msualp/sociail-assistant/docs/prototype/v3/r3-2-loose/README.md

# v3 R3.2 Loose (MagSafe)

Generated print assets for the v3.2 holistic redesign: smooth bottom-led taper, deeper edge recess, and stronger corner softness.

## What Changed vs R3
- Maintains R3 exterior polish, ergonomics, and MagSafe alignment bossing
- Looser seam tuning for faster A/B iteration and easier repeated opening
- Lower insertion force with reduced snap engagement

## Files
- `shell-top.stl`, `shell-bottom.stl`
- `shell-top-print.stl`, `shell-bottom-print.stl`
- `shell-top-print-screws.stl`, `shell-bottom-print-screws.stl`
- `neg-magsafe-ring.stl`, `neg-led-window.stl`, `neg-button.stl`
- `neg-usbc-bottom.stl`, `neg-mic-array.stl`, `neg-speaker-grill.stl`
- `neg-screw-holes-4x.stl`

## Print Orientation
- Top: seam-down (open cavity up, split plane on bed)
- Bottom: upright (flat back on bed)

## Bambu Slicer Baseline
- Layer height: `0.16` or `0.20`
- Walls: `4`
- Top/Bottom layers: `6`
- Supports: `off` (enable only if your machine/profile bridges poorly near side I/O)
