msualp/sociail-assistant/docs/prototype/v3/r3-2/README.md

# v3 R3.2 Deep Sculpt (MagSafe)

Generated print assets for the v3.2 holistic redesign: deeper perimeter recess, fuller corner softening, and stronger top-to-bottom sculpting.

## What Changed vs R2
- Larger perimeter edge rounds and softened crown transitions
- Added subtle side/shoulder contouring for improved in-hand comfort
- Added MagSafe pocket alignment bossing + anti-rotation key
- Upgraded seam to 6 snap points for stronger, more even retention
- Tuned clearances for repeatable assembly/disassembly on FDM prints
- Geometry tuned to print cleanly in recommended orientations with minimal supports

## Files
- `shell-top.stl`, `shell-bottom.stl`
- `shell-top-print.stl`, `shell-bottom-print.stl`
- `shell-top-print-screws.stl`, `shell-bottom-print-screws.stl`
- `neg-magsafe-ring.stl`, `neg-led-window.stl`, `neg-button.stl`
- `neg-usbc-bottom.stl`, `neg-mic-array.stl`, `neg-speaker-grill.stl`
- `neg-screw-holes-4x.stl`

## Print Orientation
- Top: seam-down (open cavity up, split plane on bed)
- Bottom: upright (flat back on bed)

## Bambu Slicer Baseline
- Layer height: `0.16` or `0.20`
- Walls: `4`
- Top/Bottom layers: `6`
- Supports: `off` (enable only if your machine/profile bridges poorly near side I/O)
