msualp/sociail-assistant/docs/prototype/v3/r3-1-r3-mid/README.md

# v3 R3.1-r3 Mid (MagSafe)

Generated print assets for the v3.1-r3 holistic redesign: smooth bottom-led taper, deeper edge recess, and stronger corner softness.

## What Changed vs R3
- Maintains R3 exterior polish, ergonomics, and MagSafe alignment bossing
- Mid seam tuning between r3-loose and r3-tight for balanced retention
- Moderate insertion force for daily open/close testing

## Files
- `shell-top.stl`, `shell-bottom.stl`
- `shell-top-print.stl`, `shell-bottom-print.stl`
- `shell-top-print-screws.stl`, `shell-bottom-print-screws.stl`
- `neg-magsafe-ring.stl`, `neg-led-window.stl`, `neg-button.stl`
- `neg-usbc-bottom.stl`, `neg-mic-array.stl`, `neg-speaker-grill.stl`
- `neg-screw-holes-4x.stl`

## Print Orientation
- Top: seam-down (open cavity up, split plane on bed)
- Bottom: upright (flat back on bed)

## Bambu Slicer Baseline
- Layer height: `0.16` or `0.20`
- Walls: `4`
- Top/Bottom layers: `6`
- Supports: `off` (enable only if your machine/profile bridges poorly near side I/O)
