msualp/sociail-assistant/docs/prototype/v3/r3-1-r2-tight/README.md

# v3 R3.1-r2 Tight (MagSafe)

Generated print assets for the v3.1-r2 holistic redesign: stronger all-around corner rounding and full-body trapezoidal draft shaping.

## What Changed vs R3
- Maintains R3 exterior polish, ergonomics, and MagSafe alignment bossing
- Tighter seam tuning for stronger retention under repeated handling
- Higher insertion force with increased snap engagement

## Files
- `shell-top.stl`, `shell-bottom.stl`
- `shell-top-print.stl`, `shell-bottom-print.stl`
- `shell-top-print-screws.stl`, `shell-bottom-print-screws.stl`
- `neg-magsafe-ring.stl`, `neg-led-window.stl`, `neg-button.stl`
- `neg-usbc-bottom.stl`, `neg-mic-array.stl`, `neg-speaker-grill.stl`
- `neg-screw-holes-4x.stl`

## Print Orientation
- Top: seam-down (open cavity up, split plane on bed)
- Bottom: upright (flat back on bed)

## Bambu Slicer Baseline
- Layer height: `0.16` or `0.20`
- Walls: `4`
- Top/Bottom layers: `6`
- Supports: `off` (enable only if your machine/profile bridges poorly near side I/O)
