msualp/sociail-assistant/docs/prototype/v3/templates/README.md

# v3 PCB Keepout Templates

Centered PCB templates for v3 r3 internals.

## Files
- `pcb-keepout-60x46.stl`
- `pcb-keepout-60x46.dxf`
- `pcb-keepout-62x48.stl`
- `pcb-keepout-62x48.dxf`

## Geometry Basis
- Cavity envelope: `71.6 x 58.4 x 11.2 mm`
- Bottom cavity: `6.81 mm`
- Top cavity: `4.41 mm`

## Notes
- STLs are board placeholders at `1.6 mm` thickness, centered at origin.
- DXFs include board outline, cavity reference outline, centerlines, and dimensions.
- For a stated `35 x 86 mm` board: not a fit in this enclosure (straight or diagonal) against the 71.6 x 58.4 mm cavity envelope.
