msualp/sociail-assistant/docs/prototype/v3/polished-r1/README.md

# v3 Polished R1 (MagSafe)

Generated print assets for a modern, rounded MagSafe-friendly enclosure.

## What Changed vs Draft
- Flat back maintained for MagSafe + table stability
- Softer perimeter + top crown for better in-hand feel
- Added tongue-and-groove seam and 4 snap tabs for sturdier assembly
- Normalized print-ready shells with optional screw-hole variants

## Files
- `shell-top.stl`, `shell-bottom.stl`
- `shell-top-print.stl`, `shell-bottom-print.stl`
- `shell-top-print-screws.stl`, `shell-bottom-print-screws.stl`
- `neg-magsafe-ring.stl`, `neg-led-window.stl`, `neg-button.stl`
- `neg-usbc-bottom.stl`, `neg-mic-array.stl`, `neg-speaker-grill.stl`
- `neg-screw-holes-4x.stl`

## Print Orientation
- Top: upside-down (hero face on bed)
- Bottom: upright (flat back on bed)
