msualp/sociail-assistant/docs/7-Sociail-Assistant/2-Sociail-Assistant-Strategy.md

# 📓 Sociail Wiki  
## Strategy Brief: **Sociail Assistant** Peripheral

> **Purpose**  
> Document why a pocket-sized mic / speaker / LED device—**Sociail Assistant**—can be a game-changer for our Shared-Intelligence platform, outlining benefits, risks, and a disciplined path to execution.

---

### 1 | Strategic Fit

| Dimension | How Sociail Assistant Advances the Mission |
|---|---|
| **Unified Collaboration Canvas** | Extends Sociail from _lean-forward_ chat (keyboard / screen) to _lean-back_ voice (hands-free, eyes-free). Users can move fluidly between desktop, phone, and physical spaces without context loss. |
| **Data Depth & Quality** | Captures micro-interactions (voice notes, ambient questions) that users never bother to type, enriching the Shared-Intelligence graph for smarter agent routing and RAG. |
| **Privacy & Context Management** | Space switching enables work/life separation, addressing enterprise compliance needs while respecting personal privacy. "Use Personal Space" keeps shopping lists away from team chat. |
| **Differentiation & Moat** | Competitors live inside apps. A branded, always-ready peripheral stakes physical territory. iPhone-first approach with Element-X foundation creates platform lock-in. |
| **Engagement & Retention** | The device's light/sound presence nudges daily use; habituation drives higher monthly active users (MAU) and subscription stickiness. Space switching increases usage across life contexts. |
| **New Revenue Lever** | Hardware margin (65% gross) plus bundled "Sociail Pro" upsells diversify ARR. Enterprise tiers unlock B2B field service and accessibility markets. |
| **Sustainability Leadership** | 65% recycled materials, mail-back program, and carbon neutral roadmap appeal to ESG-conscious consumers and enterprises. |

---

### 2 | Pros & Cons

| ✅ **Pros** | ❌ **Cons / Risks** | 🛠 **Mitigations** |
|---|---|---|
| **Instant AI Access** – Wake-word or tap; < 200 ms RTT. | Latency or wake-word failures hurt brand trust. | _Brain-in-Phone_ design keeps compute on iPhone; prototype until RTT < 200 ms in noisy envs. |
| **Ambient Collaboration** – RGB ring makes AI presence visible; great for teams. | Privacy concerns over "constantly listening" device. | Hardware mic-cut switch ➜ red LED; on-device wake-word; publish privacy white-paper. |
| **Cross-Context Continuity** – Car → shop → desk with one identity. | Fragmented UX if firmware, iOS app, and cloud fall out of sync. | One backlog; same PM; treat peripheral as a sprint lane of iOS roadmap. |
| **Hardware Margin & Upsell** – $99–149 MSRP, 65% gross. | Inventory ties up cash; RMAs can crush margin (cf. Humane Pin). | Crowdfund / preorder to gauge demand; CM on-demand builds; hold < 2 months inventory. |
| **TAM Expansion** – Field workers, makers, accessibility users. | Focus dilution at early stage. | Gate each phase (Alpha 20, Beta 1,000, Pilot 10,000) on NPS/usage KPIs; kill if metrics lag. |
| **Space Isolation** – Work/personal separation drives adoption. | Complexity in voice commands. | Simple commands: "Use [Space]"; visual feedback via LED patterns; in-app tutorial. |

---

### 3 | Why It Could Be a Game-Changer

1. **Creates a True "Shared Intelligence" Mesh**  
   - Chat clients cover _where we type_. Sociail Assistant covers _where we move_.  
   - Voice snippets, sensor data, and camera hand-offs fuse into a richer, time-stamped knowledge stream.
   - Space switching enables context-appropriate AI responses without privacy concerns.

2. **Unlocks Under-Served Moments**  
   - Driving, operating machinery, cooking, lab work—currently dead zones for AI collaboration.  
   - Every reclaimed minute boosts velocity of idea capture and team alignment.
   - Personal tasks (gift shopping, health tracking) stay separate from work streams.

3. **Strengthens Brand Story**  
   - Positions Sociail as the platform that **meets users where they are**, not just another chat app.  
   - Hardware acts as a physical "logo" on desk or dashboard—constant mindshare.
   - Sustainability commitment differentiates from disposable tech.

4. **Bootstraps an Ecosystem**  
   - BLE GATT is public; third parties can build mounts, sensor modules, kiosk docks.  
   - Early hardware success paves way for automotive, home-hub, and wearable variants.
   - Developer SDK enables vertical-specific applications.

---

### 4 | Execution Guard-Rails

| Stage | Go / No-Go Metric | Owner | Notes |
|---|---|---|---|
| **P0 Proof** (dev-board) | RTT < 250 ms, wake-word accuracy > 90%, Space switching works | Firmware | Use nRF52840-DK + MEMS mic shield. |
| **Alpha 20-Unit EVT** | NPS ≥ 60 from internal & power users | Product | 4-week soak; test in car/workshop/kitchen. |
| **Beta 1,000-Unit DVT** | Daily Voice Intents ≥ 10, Space adoption > 50%, attach rate > 30% | Data | A/B test $99 vs $149 pricing. |
| **Pilot 10,000-Unit PVT** | Return rate < 5%, margin ≥ 65%, enterprise LOIs ≥ 5 | Ops/Finance | Validate trade-in program, sustainability metrics. |
| **Launch** | 60,000 units Year 1, 40% subscription attach | Marketing | Retail partnerships, developer program launch. |

---

### 5 | Revenue Model Deep-Dive

| Revenue Stream | Target | Year 1 | Year 2 | Year 3 |
|---|---|---|---|---|
| **Hardware Sales** | Consumer @ $149, Wired @ $99 | $8.9M | $37.3M | $74.5M |
| **Sociail Pro** | 40% → 55% → 65% attach @ $9.99/mo | $1.4M | $9.8M | $28.4M |
| **Enterprise** | Teams @ $29.99/mo/device | $0.5M | $5.2M | $15.3M |
| **Accessories** | Mounts, sensors @ $29-49 | $0.2M | $2.1M | $8.2M |
| **Total Revenue** | | $11.0M | $54.4M | $126.4M |

---

### 6 | Risk Checklist & Mitigations

| Risk Category | Threat | Mitigation |
|---|---|---|
| **Technical** | BLE dropouts in RF-noisy shops | Classic BT fallback; antenna rigor in EVT; 5m pickup validation. |
| **Regulatory** | FCC/CE delays | Pre-scan at EVT; hire specialist lab early; UN 38.3 for battery model. |
| **Financial** | Hardware eats > 25% runway | Milestone-tied convertible note or preorder cash; enterprise pilots for revenue. |
| **Focus** | Core app lag from split attention | Shared roadmap; hardware sprints limited to 20% eng capacity until Beta success. |
| **Market** | Big-tech copycats | Patent utility (Space switching + iPhone camera integration); 18-month first-mover window. |
| **Environmental** | E-waste perception | 65% recycled materials, mail-back program, carbon neutral by 2027; B Corp cert. |
| **Privacy** | Enterprise data concerns | SOC 2 compliance, GDPR/CCPA ready, on-device wake word, E2E encryption. |

---

### 7 | Competitive Moat Timeline

| Time | Our Advantage | Competitor Response | Our Counter |
|---|---|---|---|
| **Month 0-6** | First voice peripheral for collaborative AI | Likely dismissive | Ship fast, grab mindshare |
| **Month 6-12** | iPhone integration + Space switching | Amazon/Google notice | Patent filings, exclusive Element-X features |
| **Month 12-18** | Developer ecosystem + enterprise deals | Big tech announces similar | Vertical specialization, B2B lock-in |
| **Month 18+** | Embedded base + multi-device mesh | Commoditization risk | Premium features, sensor modules, AI advances |

---

### 8 | Next-Step Checklist (Updated)

| Timeline | Action | Lead | Dependency |
|---|---|---|---|
| **Week 0-1** | Define Space voice commands & LED patterns | UX | Product vision |
| **Week 1-2** | Finalize BLE GATT & privacy architecture | iOS / FW | Security review |
| **Week 2-4** | Build P0 prototype & latency test | Firmware | Dev boards ordered |
| **Week 4-6** | Fork Element-X iOS: add Device Manager + Spaces | Mobile | Stable GATT |
| **Week 6** | Decision Gate 1: Promote to EVT? | Founders | RTT, accuracy, Space demo |
| **Month 2-3** | EVT 20-unit run + real-world testing | HW / CM | ID drawings, BOM |
| **Quarter 2** | Beta 1,000 units + preorder campaign | Marketing | EVT learnings, pricing validation |
| **Quarter 3** | Pilot 10,000 units + enterprise trials | Sales | Beta success, B2B pipeline |
| **Quarter 4** | Launch manufacturing + retail partnerships | Ops | Pilot metrics, inventory plan |

---

### 9 | Success Metrics Framework

| Metric Category | Alpha (20) | Beta (1,000) | Pilot (10,000) | Launch (60,000) |
|---|---|---|---|---|
| **Usage** | 5 intents/day | 10 intents/day | 15 intents/day | 20 intents/day |
| **Cross-Context** | 2 locations/day | 3 locations/day | 4 locations/day | 5 locations/day |
| **Space Adoption** | 30% use 2+ spaces | 50% use 2+ spaces | 70% use 2+ spaces | 80% use 2+ spaces |
| **Work/Personal Split** | - | 60/40 ratio | 50/50 ratio | Configurable |
| **NPS** | 60+ | 70+ | 75+ | 80+ |
| **Return Rate** | - | < 10% | < 5% | < 3% |
| **Sub Attach** | - | 30% | 40% | 50% |

---

### 10 | Recommendation

Proceed with an **ambitious but milestone-gated program**:

- **Cost to Beta:** <$250K (increased units for better validation)
- **Runway Impact:** 10-15% if managed well, with crowdfunding offset
- **Strategic Upside:** Massive—defines new category, locks in competitive moat, opens B2B markets
- **Sustainability Edge:** First AI hardware with circular economy commitment

> **Verdict:** _Pursue aggressively, but maintain discipline. The Space switching innovation + iPhone-first approach + sustainability story create a unique window. Scale faster than original plan to capture market before big tech responds._

### Key Strategic Insight

**Sociail Assistant isn't just a voice peripheral—it's a privacy-respecting, context-aware AI companion that makes the Sociail platform indispensable across all life moments.** The combination of Space switching, iPhone integration, and sustainable design creates multiple defensible moats.

---

*Maintainer: `@product-team` · Last updated: 2025-06-01*
