msualp/sociail-assistant/docs/7-Sociail-Assistant/5-Sociail-Assistant-Concept.html

Coming Soon

# Sociail Assistant

Bringing Shared Intelligence From Lean-Forward to Lean-Back

### 🎤 3-Mic Array with Beamforming

Far-field voice capture up to 5 meters with advanced noise cancellation. Powered by Knowles IA-611 MEMS technology.

### 🔊 Room-Filling Audio

28mm driver with 3W peak power delivers clear AI responses. Perfect for workshops, vehicles, or open spaces.

### 💡 Ambient RGB Status Ring

12 RGB LEDs show device states: ready (blue), listening (pulse), thinking (purple), speaking (green), muted (red).

### 🔋 All-Day Battery Life

1800mAh Li-Po battery provides 12+ hours of active use. USB-C fast charging and optional wireless charging.

🔌

### Connectivity

BLE 5.3 Audio, Nordic nRF52840 MCU, iPhone-first architecture with "Brain-in-Phone" design

🔋

### Power Options

Wired-only ($99) or Battery model ($149) with 12+ hours active use, Qi wireless charging

🎯

### Smart Features

Wake word on iPhone, <100ms response, multi-user voice profiles, privacy-first with hardware mute

🔮

### Expandable Platform

I²C expansion port for future sensors: temperature, air quality, gesture control, and custom modules

## Perfect For Every Situation

🔧

### Auto Repair

"Hey Sociail, torque spec for this alternator"

🚗

### Commute

Get team updates and respond hands-free

👨‍🍳

### Cooking

"Is this steak medium-rare?" with camera

🪜

### On a Ladder

Add reminders and tasks while working

♿

### Accessibility

Voice-first interface for all users

👥

### Collaboration

Pass device for group brainstorming
