msualp/sociail-assistant/docs/prototype/v2/r3-loose/README.txt

Sociail Assistant v2.0 (W35) - GENERATED R3-LOOSE POLISHED PRINT ASSETS
Generated: 2026-03-05

This folder contains parametric STL meshes generated from
../docs/design-spec.md dimensions for Bambu Studio use.

Implemented in this pass:
- 5.2mm continuous body rounds with subtle side/shoulder contouring
- 1.0mm tongue-and-groove seam (0.18mm clearance target, looser fit)
- 4x snap tabs near end arcs (+/-30deg locations), tuned for lower insertion force and easier hand assembly
- Internal-fit pack: board rails, snap-switch cradle, speaker seat, mic guides, USB collar, LED end stops, battery tray

Canonical parts:
- shell-top.stl
- shell-bottom.stl

Negative cutouts:
- neg-usbc-left-tunnel.stl
- neg-led-window.stl
- neg-button-well.stl
- neg-mic-array.stl
- neg-speaker-grill.stl
- neg-screw-holes-4x.stl (optional)

Direct print-ready variants:
- shell-top-print.stl
- shell-bottom-print.stl
- shell-top-print-screws.stl
- shell-bottom-print-screws.stl

Bambu orientation:
- Top shell: upside-down (hero side on bed)
- Bottom shell: upright (cavity up)
