msualp/sociail-assistant/docs/prototype/modules/button-module-22-24-v1/bezel_guard_22mm.stl

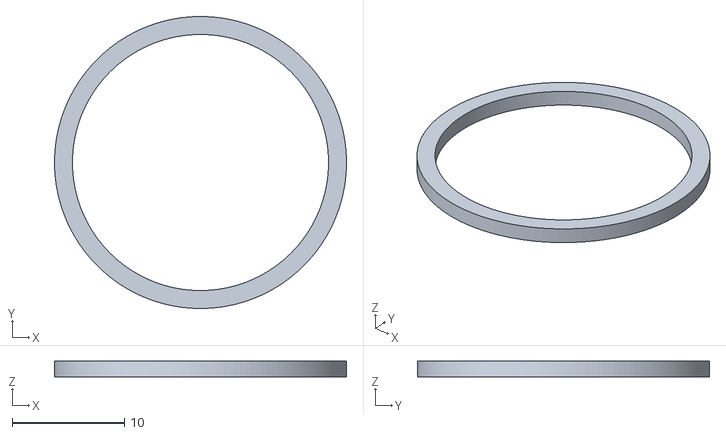
[picture p1: CAD file, 2026-03-05]
docs/prototype/modules/button-module-22-24-v1/bezel_guard_22mm.stl
26.0 x 26.0 x 1.40
