msualp/sociail-assistant/docs/prototype/v3/r3-1-r3-loose/neg-mic-array.stl

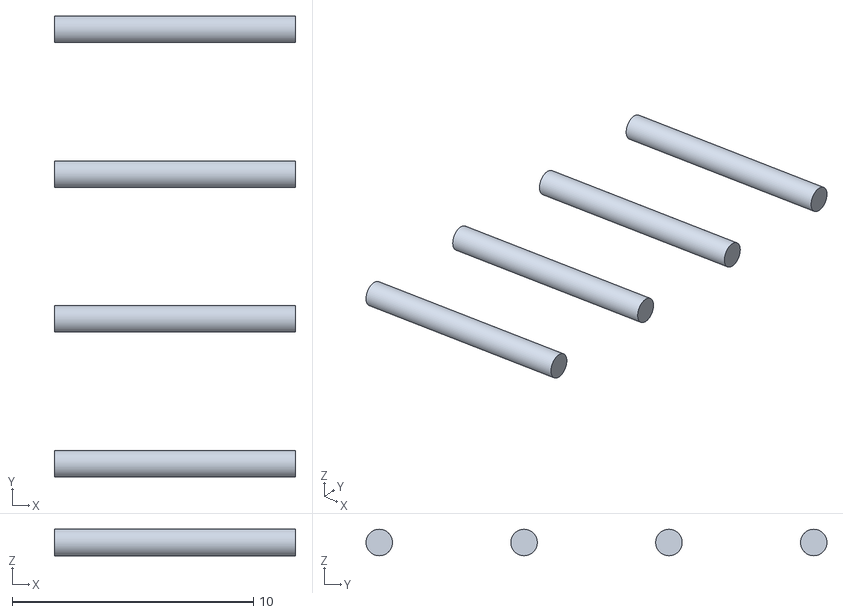
[picture p2: CAD file, 2026-03-05]
docs/prototype/v3/r3-1-r3-loose/neg-mic-array.stl
10.0 x 19.1 x 1.10
