msualp/sociail-assistant/docs/prototype/v3/r3-1-r3-tight/neg-usbc-bottom.stl

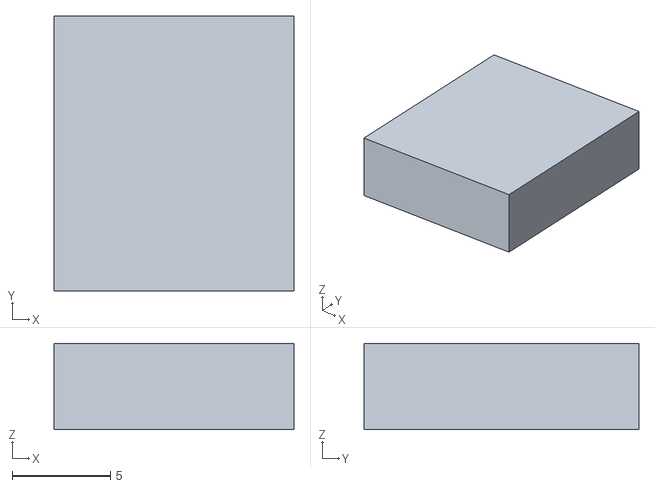
[picture p3: CAD file, 2026-03-05]
docs/prototype/v3/r3-1-r3-tight/neg-usbc-bottom.stl
12.2 x 14.0 x 4.40
