msualp/sociail-assistant/docs/prototype/v3/r3-1-r3/neg-led-window.stl

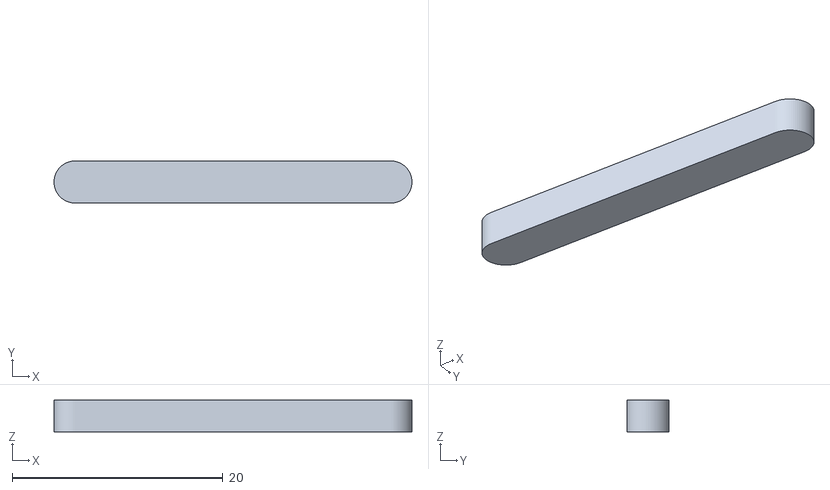
[picture p4: CAD file, 2026-03-05]
docs/prototype/v3/r3-1-r3/neg-led-window.stl
34.0 x 4.00 x 3.00
