msualp/sociail-assistant/docs/prototype/v3/r3-2-loose/neg-button.stl

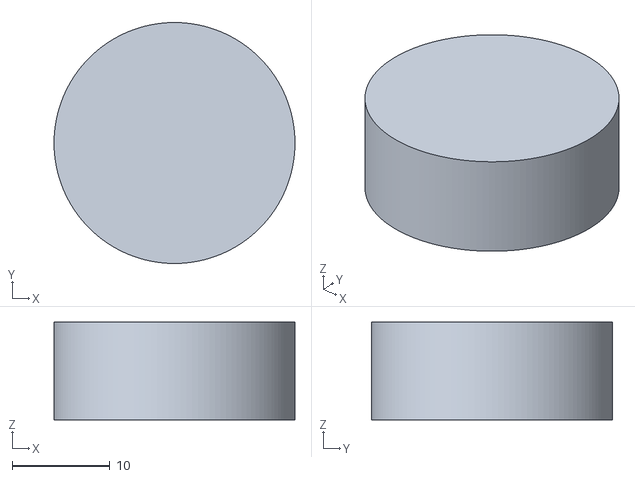
[picture p5: CAD file, 2026-03-05]
docs/prototype/v3/r3-2-loose/neg-button.stl
24.6 x 24.6 x 10.0
