msualp/sociail-assistant/docs/prototype/v3/sheets-r3-1-r2/r3-1-r2-button-c-sheet.stl

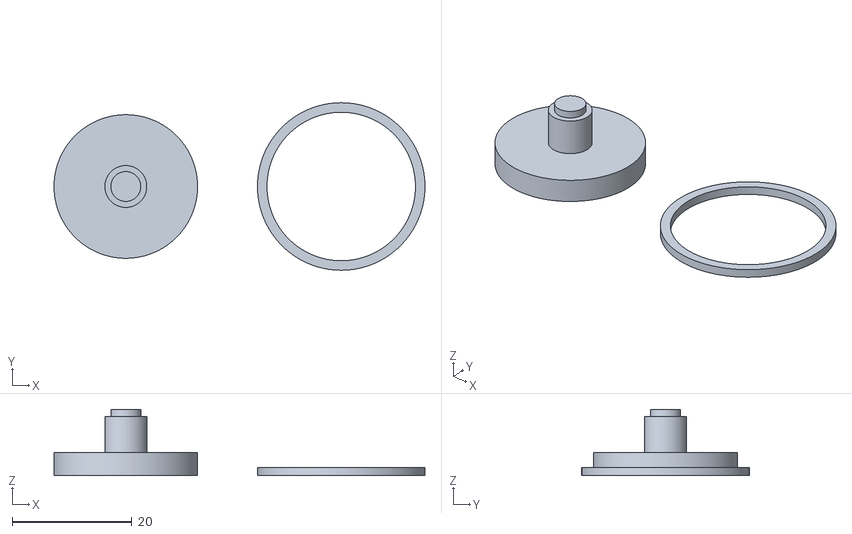
[picture p6: CAD file, 2026-03-07]
docs/prototype/v3/sheets-r3-1-r2/r3-1-r2-button-c-sheet.stl
62.0 x 28.0 x 11.1
