msualp/sociail-assistant/docs/prototype/v3/templates/pcb-keepout-62x48.stl

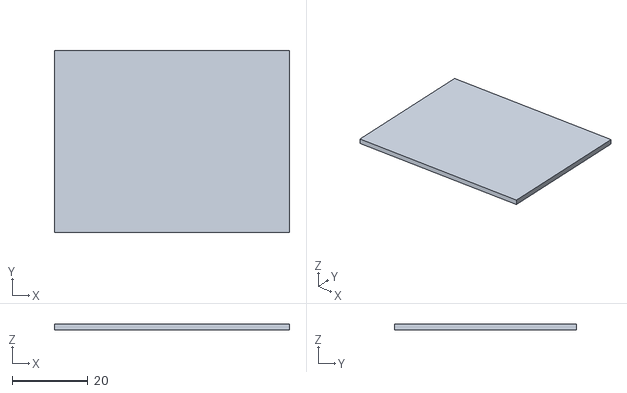
[picture p7: CAD file, 2026-03-05]
docs/prototype/v3/templates/pcb-keepout-62x48.stl
62.0 x 48.0 x 1.60
