msualp/sociail-assistant/docs/prototype/modules/button-module-22-24-v1/plunger_concave_22mm.stl

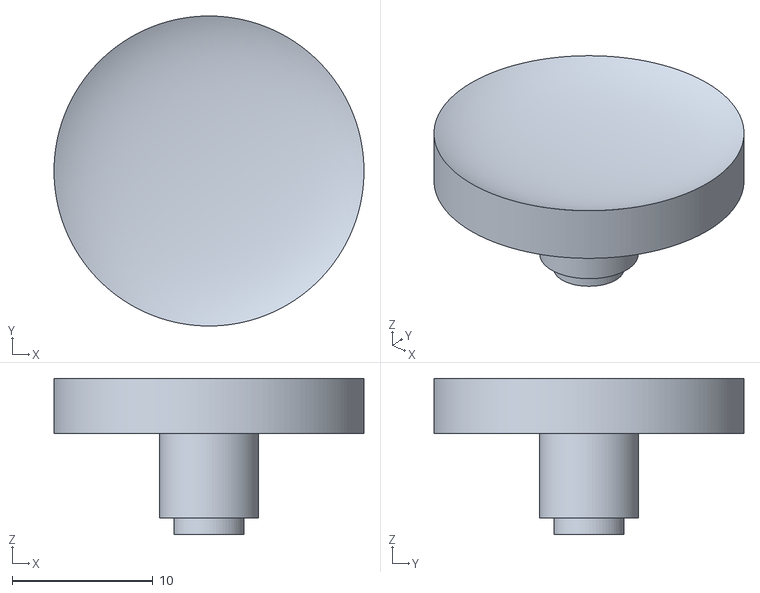
[picture p8: CAD file, 2026-03-05]
docs/prototype/modules/button-module-22-24-v1/plunger_concave_22mm.stl
22.0 x 22.0 x 11.1
