msualp/sociail-assistant/docs/prototype/v3/r3-1-r3/neg-magsafe-ring.stl

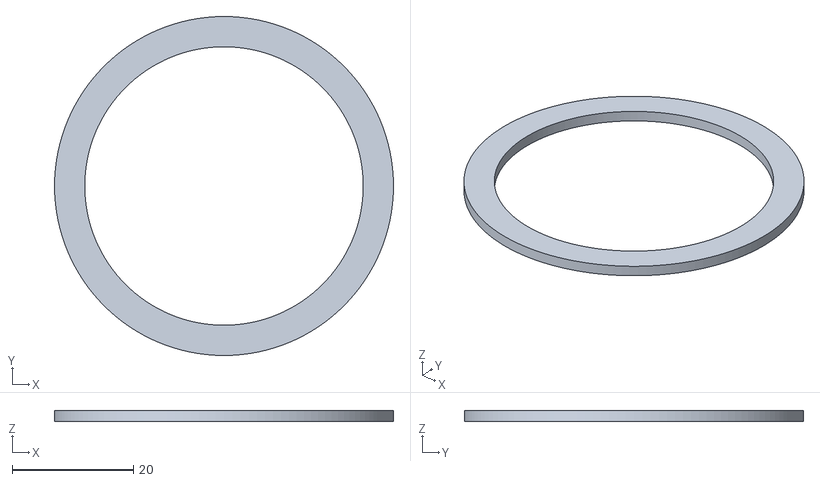
[picture p9: CAD file, 2026-03-05]
docs/prototype/v3/r3-1-r3/neg-magsafe-ring.stl
56.0 x 56.0 x 1.80
