msualp/sociail-assistant/docs/prototype/v3/templates/pcb-keepout-60x46.stl

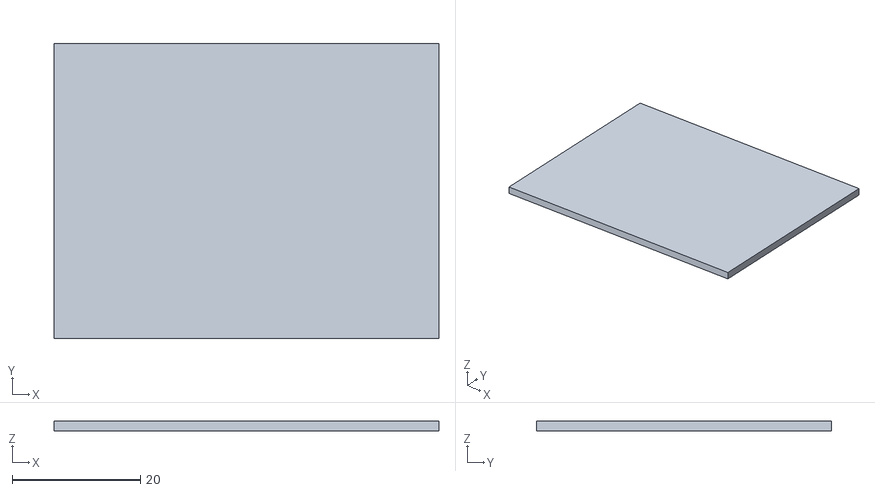
[picture p10: CAD file, 2026-03-05]
docs/prototype/v3/templates/pcb-keepout-60x46.stl
60.0 x 46.0 x 1.60
