msualp/sociail-assistant/docs/prototype/modules/button-module-22-24-v1/plunger_concave_24mm.stl

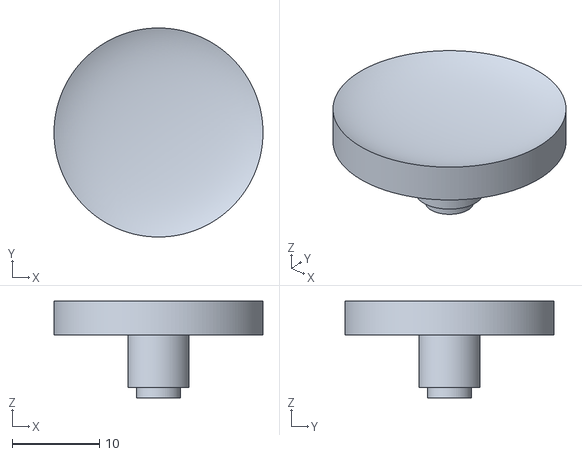
[picture p11: CAD file, 2026-03-05]
docs/prototype/modules/button-module-22-24-v1/plunger_concave_24mm.stl
24.0 x 24.0 x 11.1
