msualp/sociail-assistant/docs/prototype/modules/button-module-22-24-v1/bezel_guard_24mm.stl

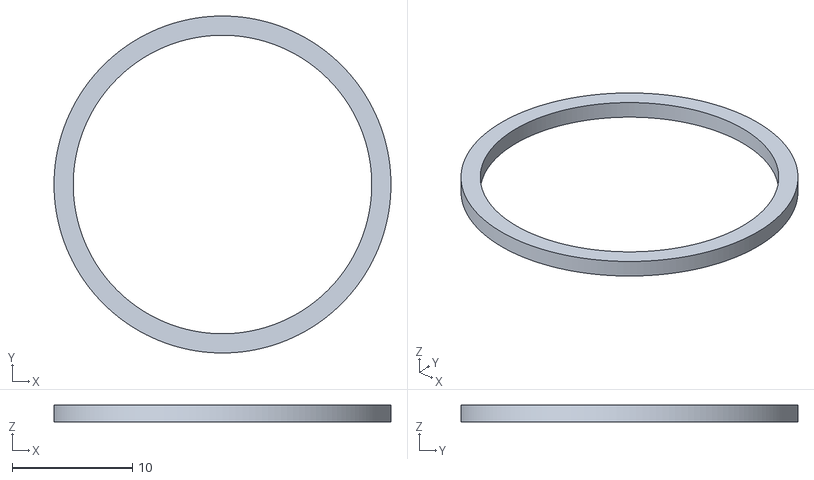
[picture p12: CAD file, 2026-03-05]
docs/prototype/modules/button-module-22-24-v1/bezel_guard_24mm.stl
28.0 x 28.0 x 1.40
