msualp/sociail-assistant/docs/prototype/v3/draft/neg-button.stl

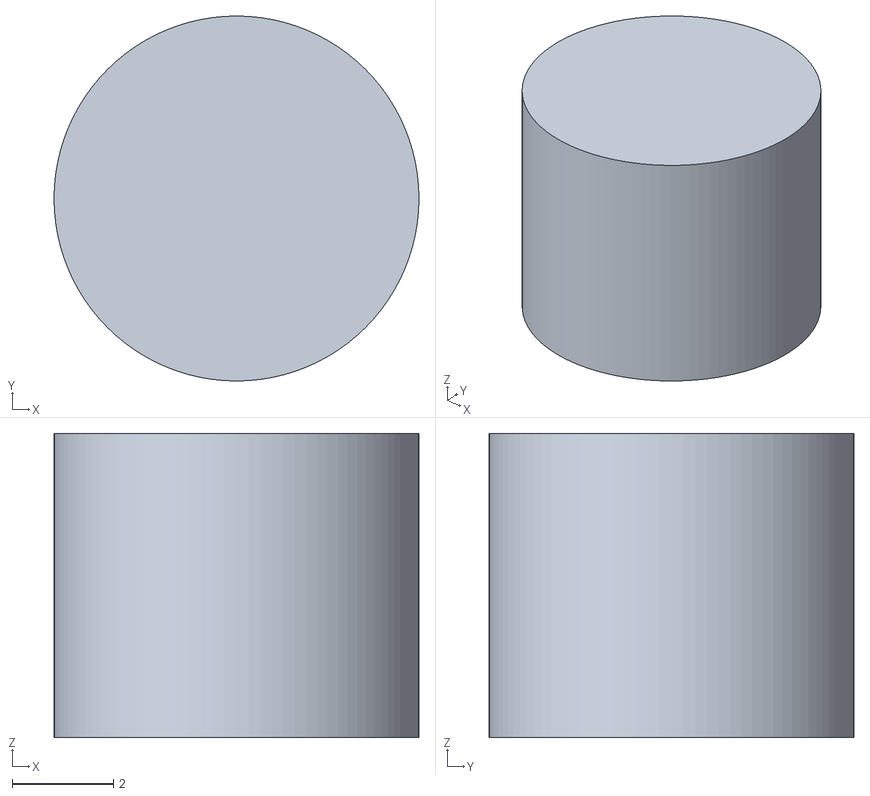
[picture p13: CAD file, 2026-03-05]
docs/prototype/v3/draft/neg-button.stl
7.20 x 7.20 x 6.00
