msualp/sociail-assistant/docs/prototype/modules/button-module-22-24-v1/neg_button_cutout_22mm.stl

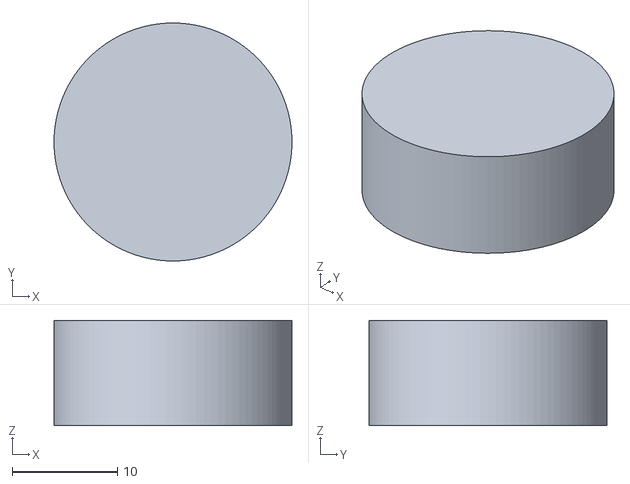
[picture p14: CAD file, 2026-03-05]
docs/prototype/modules/button-module-22-24-v1/neg_button_cutout_22mm.stl
22.6 x 22.6 x 10.0
