msualp/sociail-assistant/docs/prototype/v3/draft/neg-magsafe-ring.stl

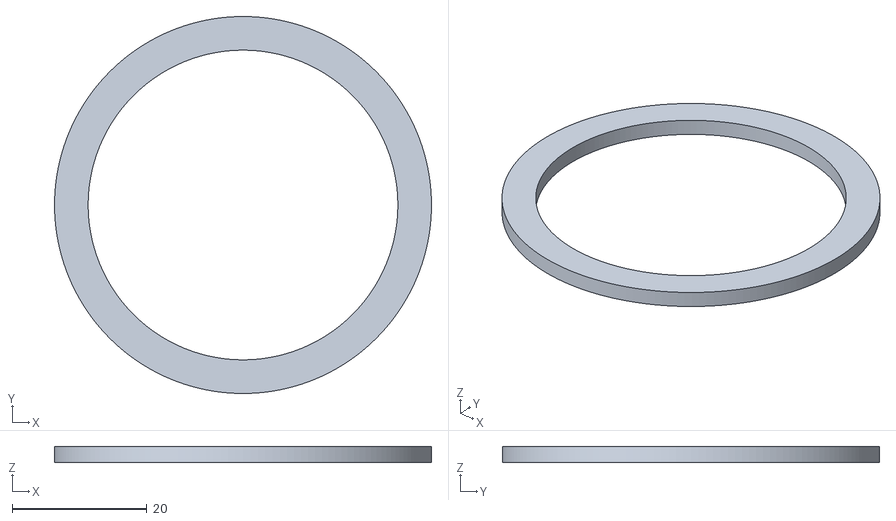
[picture p15: CAD file, 2026-03-05]
docs/prototype/v3/draft/neg-magsafe-ring.stl
56.0 x 56.0 x 2.40
