msualp/sociail-assistant/(list of files, cad)

Other CAD files:
docs/prototype/v3/draft/neg-usbc-bottom.stl
docs/prototype/modules/button-module-22-24-v1/neg_button_cutout_24mm.stl
docs/prototype/v1/w55-negatives/neg-button.stl
docs/prototype/v1/w55-negatives/neg-led-window.stl
docs/prototype/v1/w55-negatives/neg-mic-array.stl
docs/prototype/v1/w55-negatives/neg-screw-holes-4x.stl
docs/prototype/v1/w55-negatives/neg-speaker-grill.stl
docs/prototype/v1/w55-negatives/neg-usbc-left.stl
docs/prototype/v1/w55-negatives/shell-bottom.stl
docs/prototype/v1/w55-negatives/shell-top.stl
docs/prototype/v1/w55-print-ready/shell-bottom-print.stl
docs/prototype/v1/w55-print-ready/shell-top-print-screws.stl
docs/prototype/v1/w55-print-ready/shell-top-print.stl
docs/prototype/v2/base/neg-button-well.stl
docs/prototype/v2/base/neg-led-window.stl
docs/prototype/v2/base/shell-bottom.stl
docs/prototype/v2/base/shell-top-print-screws.stl
docs/prototype/v2/base/shell-top-print.stl
docs/prototype/v2/base/shell-top.stl
docs/prototype/v2/r2-loose/neg-button-well.stl
docs/prototype/v2/r2-loose/neg-led-window.stl
docs/prototype/v2/r2-loose/shell-bottom.stl
docs/prototype/v2/r2-loose/shell-top-print-screws.stl
docs/prototype/v2/r2-loose/shell-top-print.stl
docs/prototype/v2/r2-loose/shell-top.stl
docs/prototype/v2/r2-tight/neg-button-well.stl
docs/prototype/v2/r2-tight/neg-led-window.stl
docs/prototype/v2/r2-tight/shell-bottom.stl
docs/prototype/v2/r2-tight/shell-top-print-screws.stl
docs/prototype/v2/r2-tight/shell-top-print.stl
docs/prototype/v2/r2-tight/shell-top.stl
docs/prototype/v2/r3-loose/neg-button-well.stl
docs/prototype/v2/r3-loose/neg-led-window.stl
docs/prototype/v2/r3-loose/neg-mic-array.stl
docs/prototype/v2/r3-loose/neg-screw-holes-4x.stl
docs/prototype/v2/r3-loose/neg-speaker-grill.stl
docs/prototype/v2/r3-loose/neg-usbc-left-recess.stl
docs/prototype/v2/r3-loose/neg-usbc-left-tunnel.stl
docs/prototype/v2/r3-loose/shell-bottom.stl
docs/prototype/v2/r3-loose/shell-top-print-screws.stl
docs/prototype/v2/r3-loose/shell-top-print.stl
docs/prototype/v2/r3-loose/shell-top.stl
docs/prototype/v2/r3-mid/neg-button-well.stl
docs/prototype/v2/r3-mid/neg-led-window.stl
docs/prototype/v2/r3-mid/neg-mic-array.stl
docs/prototype/v2/r3-mid/neg-screw-holes-4x.stl
docs/prototype/v2/r3-mid/neg-speaker-grill.stl
docs/prototype/v2/r3-mid/neg-usbc-left-recess.stl
docs/prototype/v2/r3-mid/neg-usbc-left-tunnel.stl
docs/prototype/v2/r3-mid/shell-bottom.stl
docs/prototype/v2/r3-mid/shell-top-print-screws.stl
docs/prototype/v2/r3-mid/shell-top-print.stl
docs/prototype/v2/r3-mid/shell-top.stl
docs/prototype/v2/r3-tight/neg-button-well.stl
docs/prototype/v2/r3-tight/neg-led-window.stl
docs/prototype/v2/r3-tight/neg-mic-array.stl
docs/prototype/v2/r3-tight/neg-screw-holes-4x.stl
docs/prototype/v2/r3-tight/neg-speaker-grill.stl
docs/prototype/v2/r3-tight/neg-usbc-left-recess.stl
docs/prototype/v2/r3-tight/neg-usbc-left-tunnel.stl
docs/prototype/v2/r3-tight/shell-bottom.stl
docs/prototype/v2/r3-tight/shell-top-print-screws.stl
docs/prototype/v2/r3-tight/shell-top-print.stl
docs/prototype/v2/r3-tight/shell-top.stl
docs/prototype/v3/draft/neg-led-window.stl
docs/prototype/v3/draft/neg-mic-array.stl
docs/prototype/v3/draft/neg-screw-holes-4x.stl
docs/prototype/v3/draft/neg-speaker-grill.stl
docs/prototype/v3/draft/shell-bottom.stl
docs/prototype/v3/draft/shell-top.stl
docs/prototype/v3/polished-r1/neg-screw-holes-4x.stl
docs/prototype/v3/r2-loose/neg-screw-holes-4x.stl
docs/prototype/v3/r2-tight/neg-screw-holes-4x.stl
docs/prototype/v3/r3-1-loose/neg-screw-holes-4x.stl
docs/prototype/v3/r3-1-mid/neg-screw-holes-4x.stl
docs/prototype/v3/r3-1-r2-loose/neg-screw-holes-4x.stl
docs/prototype/v3/r3-1-r2-mid/neg-screw-holes-4x.stl
docs/prototype/v3/r3-1-r2-tight/neg-screw-holes-4x.stl
docs/prototype/v3/r3-1-r2/neg-screw-holes-4x.stl
docs/prototype/v3/r3-1-r3-loose/neg-screw-holes-4x.stl
docs/prototype/v3/r3-1-r3-mid/neg-screw-holes-4x.stl
docs/prototype/v3/r3-1-r3-tight/neg-screw-holes-4x.stl
docs/prototype/v3/r3-1-r3/neg-screw-holes-4x.stl
docs/prototype/v3/r3-1-tight/neg-screw-holes-4x.stl
docs/prototype/v3/r3-1/neg-screw-holes-4x.stl
docs/prototype/v3/r3-2-loose/neg-screw-holes-4x.stl
docs/prototype/v3/r3-2-mid/neg-screw-holes-4x.stl
docs/prototype/v3/r3-2-tight/neg-screw-holes-4x.stl
docs/prototype/v3/r3-2/neg-screw-holes-4x.stl
docs/prototype/v3/r3-internals-v1-loose/neg-screw-holes-4x.stl
docs/prototype/v3/r3-internals-v1-tight/neg-screw-holes-4x.stl
docs/prototype/v3/r3-internals-v1/neg-screw-holes-4x.stl
docs/prototype/v3/r3-loose/neg-screw-holes-4x.stl
docs/prototype/v3/r3-mid/neg-screw-holes-4x.stl
docs/prototype/v3/r3-tight/neg-screw-holes-4x.stl
docs/prototype/v3/r3/neg-screw-holes-4x.stl
docs/prototype/v3/templates/pcb-keepout-60x46.dxf
docs/prototype/v3/templates/pcb-keepout-62x48.dxf
