msualp/sociail-assistant/docs/prototype/v1/w55-print-ready/README.txt

Sociail Assistant Enclosure v1.2 (W55) - BAMBU READY
Generated: 2026-02-17

Purpose
- This bundle contains pre-subtracted STL files that open directly in Bambu Studio.
- You do NOT need to add negative parts for USB-C / LED / button / mic / speaker.

Files
- shell-top-print.stl
  Includes: LED window + button well cutouts

- shell-bottom-print.stl
  Includes: USB-C opening + mic holes + speaker grill cutouts

Optional screw-hole pair
- shell-top-print-screws.stl
- shell-bottom-print-screws.stl

These files include screw holes in both shells.
If you prefer slicer-time control instead, use:
../w55-negatives/neg-screw-holes-4x.stl

Bambu Studio orientation
- Top shell: upside-down (hero face on bed)
- Bottom shell: upright (cavity facing up)

Recommended profiles (P1S, 0.4mm nozzle)
- Iteration: 0.12mm layer, 4 walls, 12% gyroid, supports OFF
- Hero: 0.08mm layer, 4-5 walls, 15% gyroid, outer wall 40mm/s, supports OFF

Validation notes
- All STLs passed MeshLib closed-mesh validity checks.
- Units are millimeters.
