msualp/sociail-assistant/(commit log)

2025-06-03 Initial commit: Add Sociail Assistant landing page
2025-06-03 feat: Complete Sociail Assistant landing page enhancements
    - Add professional mobility grid with uniform boxes and arrows
    - Implement perfect desktop (2x2) and mobile (vertical) layouts
    - Update use cases to show relatable day progression with context switching
    - Add 'Hey Sociail' wake word examples throughout
    - Demonstrate space switching capabilities (Personal, Meetings Channel, Marketing, Family)
    - Fix mobile responsiveness with proper arrow hiding
    - Update copy to be device-agnostic (works with phone, laptop, desktop)
    - Enhance concentric circles with radial fade effect
    - Position 'Hey Sociail!' text above device with modern gradient
    - Maintain perfect dark/light mode compatibility
    - Opt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
2026-01-11 fix: Improve device positioning and visibility in hero animation
    - Adjust iPhone silhouette positioning for better visibility
    - Desktop: left -50px → -25px, top 30% → 38%
    - Mobile: left -30px → -15px, add top 38%
    - Adjust laptop silhouette positioning for better visibility
    - Desktop: right -160px → -100px, top 30% → 38%
    - Mobile: right -90px → -50px, add top 38%
    - Add z-index: 20 and cursor: pointer to device-float for
    better interactivity and layering
    - Move "Hey Sociail!" text slightly closer to device (top 15% → 18%)
    These changes ensure iPhone and laptop show approximately 60% of their
    width instead of being mostly cut off, and vertically center them
    between t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
2026-01-11 feat: Add interactive hover tooltips to device animation
    Add tooltip popups that appear on hover for all three devices in the
    hero animation section:
    - iPhone: Tooltip appears on right with iPhone Integration features
    - Laptop: Tooltip appears on left with Desktop Power features
    - Assistant: Tooltip appears below with Sociail Assistant features
    Implementation details:
    - Device hotspot wrappers handle positioning and hover detection
    - Tooltips have high z-index (10000) with smooth fade-in animation
    - Hero section z-index (10) > features section (1) to prevent clipping
    - Glow effect on device hover for visual feedback
    - Tooltips hidden on mobile (hover doesn't work on touch devices)
    - New fl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
2026-01-11 feat: Add accessibility polish and prototype documentation
    Accessibility improvements:
    - Add focus-visible states to nav links, theme toggle, space bubbles, form elements
    - Replace inline hover handlers on pricing cards with CSS :hover/:focus-visible
    - Add .sr-only utility class for screen readers
    - Add tabindex to pricing cards for keyboard navigation
    Code quality:
    - Extract pricing card inline styles to CSS classes
    - Add semantic color variables (success, error, warning)
    - Replace hard-coded colors with CSS variables
    - Update .gitignore to exclude .DS_Store, .lh/, .history/
    Documentation:
    - Add prototype enclosure STL files and design runbooks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
2026-01-11 feat: polish landing and add health endpoint
2026-01-13 style: enhance hero device hover
2026-01-13 style: adjust hero device positions
2026-01-13 style: refine hero tooltip and device offset
2026-01-13 feat: cycle hero prompts on device hover
2026-01-13 style: sync hero prompt with device motion
2026-01-13 style: scale hero device scene on large screens
2026-01-14 Revert "style: scale hero device scene on large screens"
    This reverts commit f3775eeea509976422b05fffbe219321ae2e479e.
2026-01-14 style: layer assistant device above tooltip
2026-02-26 feat: add v2.0 pill-form enclosure design specification
    - Add complete v2.0 design spec (85x35x14mm pill shape)
    - Add Apple-inspired rounded aesthetics with 4mm edge fillets
    - Include Fusion 360 parametric workflow guide
    - Add curved surface printing and post-processing guidance
    - Create STL bundle README template
    - Update CLAUDE.md with single test execution commands
2026-03-05 refactor: remove legacy prototype files
    Delete old long-named zip files and documentation that have been
    reorganized into versioned folder structure.
2026-03-05 feat: add v1 prototype assets (bar form factor)
    Reorganized v1.2 bar form factor (150x55x22mm) with short filenames:
    - w55-negatives/: base shells + negative cutouts for Bambu Studio
    - w55-print-ready/: direct-print STLs with booleans applied
    - scripts/: build automation
    [neg-button.stl, neg-led-window.stl, neg-mic-array.stl, neg-screw-holes-4x.stl, neg-speaker-grill.stl, neg-usbc-left.stl, shell-bottom-print.stl, shell-bottom.stl]
2026-03-05 feat: add v2 prototype assets (pill form factor)
    Apple-inspired pill form factor (85x35x14mm) with variants:
    - docs/: design spec, runbooks, bundle template
    - base/: base geometry + print-ready STLs
    - r2-loose/: looser snap-fit tuning
    - r2-tight/: tighter snap-fit tuning
    - scripts/: build automation for each variant
    [neg-button-well.stl, neg-led-window.stl, neg-mic-array.stl, neg-screw-holes-4x.stl, neg-speaker-grill.stl, neg-usbc-left-recess.stl, shell-bottom.stl, shell-top-print-screws.stl]
2026-03-05 feat: add v3 prototype assets (MagSafe form factor)
    New MagSafe-compatible design with multiple iterations:
    - draft/: initial MagSafe concept
    - polished-r1/: first polished iteration
    - r2-loose/, r2-tight/, r3/: snap-fit tuning variants
    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
    [neg-button.stl, neg-led-window.stl, neg-magsafe-ring.stl, neg-mic-array.stl, neg-screw-holes-4x.stl, neg-speaker-grill.stl, neg-usbc-bottom.stl, shell-bottom.stl]
2026-03-05 docs: add prototype directory README
    Explains folder structure, naming conventions, and organization
    for v1 (bar), v2 (pill), and v3 (MagSafe) prototype generations.
2026-03-05 docs: add ESP32S3 wake word internals build doc
    Comprehensive v1 build documentation for on-device wake word:
    - XIAO ESP32S3 Sense as recommended board
    - PDM mic configuration and code skeletons
    - Power budget analysis (12-16 hour target)
    - BLE protocol and state machine
    - Wake word tuning protocol with false positive targets
    - iOS background limitations documented
    - Shopping list with Amazon links
    - Timeout and error recovery state machine
    - Out of scope items explicitly listed
    v1 uses "Hi ESP" wake phrase; branded "Hey Sociail" deferred to v1.5.
2026-03-05 feat: add v3 internal fit pack variants
    MagSafe enclosure internals with XIAO ESP32S3 Sense mounting:
    - r3-internals-v1/: base internal geometry
    - r3-internals-v1-loose/: looser board retention
    - r3-internals-v1-tight/: tighter board retention
    Features:
    - XIAO ESP32S3 Sense cradle (21x17.5mm board class)
    - LiPo tray for 800-1000mAh cells (~55x34mm footprint)
    - Auxiliary shelf for MAX17048 or voltage divider
    - Wire routing channels for clean closure
    [neg-button.stl, neg-led-window.stl, neg-magsafe-ring.stl, neg-mic-array.stl, neg-screw-holes-4x.stl, neg-usbc-bottom.stl]
2026-03-05 feat: add v3 r3-mid snap-fit tuning variant
    Mid-range snap-fit tolerance for MagSafe enclosure.
    Baseline tuning between loose and tight variants.
    [neg-button.stl, neg-led-window.stl, neg-magsafe-ring.stl, neg-mic-array.stl, neg-screw-holes-4x.stl, neg-usbc-bottom.stl]
2026-03-05 feat: add v3 PCB templates and component sheets
    Reference files for internal component layout:
    - templates/: PCB footprint templates
    - sheets/: component placement sheets
    [pcb-keepout-60x46.dxf, pcb-keepout-60x46.stl, pcb-keepout-62x48.dxf, pcb-keepout-62x48.stl]
2026-03-05 feat: add v3 build scripts for new variants
    Build automation scripts:
    - build-assets-r3-internals-v1.py (base)
    - build-assets-r3-internals-v1-loose.py
    - build-assets-r3-internals-v1-tight.py
    - build-assets-r3-mid.py
    - build-r3-pcb-templates.py
    - build-r3-sheets.py
2026-03-05 docs: update prototype README with v3 internals
    Add documentation for new v3 internal fit pack variants
    and component templates.
2026-03-05 feat(v2): add r3 snap-fit tuning variants
    Three tolerance variants for pill form factor:
    - r3-loose: +0.15mm clearance for easier assembly
    - r3-mid: baseline fit (production target)
    - r3-tight: -0.10mm for interference fit testing
    Each includes shell-top, shell-bottom, print-ready versions,
    screw-hole variants, and subtractive negatives.
    [neg-button-well.stl, neg-led-window.stl, neg-mic-array.stl, neg-screw-holes-4x.stl, neg-speaker-grill.stl, neg-usbc-left-recess.stl, shell-bottom.stl, shell-top-print-screws.stl]
2026-03-05 feat(v2): add r3 build and sheet scripts
    Build scripts for generating r3 variant assets:
    - build-assets-r3-loose.py: loose tolerance variant
    - build-assets-r3-mid.py: baseline mid variant
    - build-assets-r3-tight.py: tight tolerance variant
    - build-r3-sheets.py: combined plate STLs for Bambu Studio
    - cleanup-shell-components.py: utility for mesh cleanup
2026-03-05 feat(v2): add r3 sheet plates for Bambu Studio
    Single-file combined STLs for quick import:
    - r3-loose-pair-sheet.stl: top+bottom for loose variant
    - r3-mid-pair-sheet.stl: top+bottom for mid variant
    - r3-tight-pair-sheet.stl: top+bottom for tight variant
    - r3-abc-6up-sheet.stl: all 6 parts (3 tops + 3 bottoms)
    - *-screws.stl variants with screw hole geometry
    Intended for 256x256mm+ print beds.
2026-03-05 docs(v2): add r3 polish notes and update prototype README
    - r3-polish-notes.md: design decisions and tuning rationale
    - Updated README with v2 r3 variants and sheets structure
2026-03-05 chore(v2): regenerate base and r2 variant STLs
    Updated geometry for base, r2-loose, and r2-tight variants
    after build script improvements.
    [neg-button-well.stl, neg-led-window.stl, shell-bottom.stl, shell-top-print-screws.stl, shell-top-print.stl, shell-top.stl]
2026-03-05 chore(v2): regenerate r3 variant STLs
    Updated geometry for r3-loose, r3-mid, and r3-tight variants
    after build script refinements.
    [neg-button-well.stl, neg-led-window.stl, shell-bottom.stl, shell-top-print-screws.stl, shell-top-print.stl, shell-top.stl]
2026-03-05 chore(v2): regenerate sheets and add bottoms-3up plates
    Updated sheet STLs and added new r3-abc-bottoms-3up-sheet
    variants for isolated bottom testing.
2026-03-05 chore(v3): regenerate polished-r1 and r2 variant STLs
    Updated geometry for polished-r1, r2-loose, and r2-tight
    variants after build script refinements.
    [neg-button.stl]
2026-03-05 chore(v3): regenerate r3 variant STLs
    Updated geometry for r3, r3-loose, r3-mid, and r3-tight
    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
    [neg-button.stl]
2026-03-05 chore(v3): regenerate r3-internals-v1 variant STLs
    Updated geometry for r3-internals-v1, r3-internals-v1-loose,
    and r3-internals-v1-tight variants.
    [neg-button.stl]
2026-03-05 chore(v3): regenerate sheets and remove temp file
    Updated sheet STLs and removed temporary _tmp-side-test.stl.
2026-03-05 docs: update internals doc and prototype structure
    - internals-v1-esp32s3-wakeword.md: refinements and corrections
    - prototype README: updated v2/v3 structure documentation
    - r3-polish-notes.md: design decision updates
2026-03-05 feat: add button module 22-24mm v1
    Standalone button module components:
    - bezel_guard_22mm/24mm.stl: rigid protective bezels
    - neg_button_cutout_22mm/24mm.stl: shell cutout negatives
    - plunger_concave_22mm/24mm.stl: TPU concave plungers
    - Build script for regeneration
    Default size: 24mm with 0.6mm clearance.
    [bezel_guard_22mm.stl, bezel_guard_24mm.stl, neg_button_cutout_22mm.stl, neg_button_cutout_24mm.stl, plunger_concave_22mm.stl, plunger_concave_24mm.stl]
2026-03-05 docs(v3): add button module r3 integration notes
    Documents button module integration into v3 build scripts:
    - Default 24mm plunger with 0.6mm clearance
    - Button placement at x=0, y=-8 for thumb reach
    - Script families updated for new button system
2026-03-05 feat(v2): add button and material-test sheet plates
    New sheet types for streamlined AMS workflows:
    - r3-abc-6up-kit-sheet.stl: shells + buttons (12 parts)
    - r3-abc-buttons-6up-sheet.stl: plungers + bezels only (6 parts)
    - r3-case-a/b/c-sheet.stl: per-variant case pairs
    - r3-button-a/b/c-sheet.stl: per-variant button pairs
    A/B/C mapping: A=r3-loose, B=r3-mid, C=r3-tight
    [r3-button-a-sheet.stl, r3-button-b-sheet.stl, r3-button-c-sheet.stl]
2026-03-05 feat(v3): add button and material-test sheet plates
    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
    [r3-button-a-sheet.stl, r3-button-b-sheet.stl, r3-button-c-sheet.stl]
2026-03-05 docs: add Amazon shopping list for v2/v3 prototype
    Consolidated parts list aligned with current designs:
    - XIAO ESP32S3 Sense MCU
    - WS2812B LED strip, LiPo battery, MagSafe rings
    - Printing materials (TPU, PLA+, PETG)
    - Button tuning supplies
2026-03-07 chore(v2): regenerate all variant STLs
    Updated shell geometry for base, r2, and r3 variants.
    [shell-top-print-screws.stl, shell-top-print.stl, shell-top.stl]
2026-03-07 chore(v2): update scripts and regenerate sheets
    Updated build scripts and sheet plates including new
    default cases/buttons plates.
    [r3-button-a-sheet.stl, r3-button-b-sheet.stl, r3-button-c-sheet.stl]
2026-03-07 chore(v3): regenerate sheets and add default plates
    Updated sheet STLs and added default cases/buttons plates.
    [r3-button-a-sheet.stl, r3-button-b-sheet.stl, r3-button-c-sheet.stl]
2026-03-10 feat(v3): add r3-1 snap-fit tuning variants
    New r3-1 base plus loose/mid/tight tolerance variants.
    [neg-button.stl, neg-led-window.stl, neg-magsafe-ring.stl, neg-mic-array.stl, neg-screw-holes-4x.stl, neg-usbc-bottom.stl]
2026-03-10 feat(v3): add r3-1-r2 snap-fit tuning variants
    R3-1-r2 base plus loose/mid/tight tolerance variants.
    [neg-button.stl, neg-led-window.stl, neg-magsafe-ring.stl, neg-mic-array.stl, neg-screw-holes-4x.stl, neg-usbc-bottom.stl]
2026-03-10 feat(v3): add r3-1-r3 snap-fit tuning variants
    R3-1-r3 base plus loose/mid/tight tolerance variants.
    [neg-button.stl, neg-led-window.stl, neg-magsafe-ring.stl, neg-mic-array.stl, neg-screw-holes-4x.stl, neg-usbc-bottom.stl]
2026-03-10 feat(v3): add r3-2 snap-fit tuning variants
    R3-2 base plus loose/mid/tight tolerance variants.
    [neg-button.stl, neg-led-window.stl, neg-magsafe-ring.stl, neg-mic-array.stl, neg-screw-holes-4x.stl, neg-usbc-bottom.stl]
2026-03-10 feat(v3): add sheet plates for r3-1 and r3-2 variants
    Combined plate STLs for new variant families.
    [r3-1-button-a-sheet.stl, r3-1-button-b-sheet.stl, r3-1-button-c-sheet.stl, r3-1-r2-button-a-sheet.stl, r3-1-r2-button-b-sheet.stl, r3-1-r2-button-c-sheet.stl, r3-1-r3-button-a-sheet.stl, r3-1-r3-button-b-sheet.stl]
2026-03-13 chore(v2): update r3 variants with USB-C tunnel negative
    Added neg-usbc-left-tunnel.stl and updated shell geometry.
    [neg-usbc-left-tunnel.stl, shell-top-print.stl]
2026-03-13 chore(v2): regenerate sheet plates
2026-03-13 docs: add prototype parts list
2026-03-13 feat: add combined sheet build script
    Script to generate latest combined v2/v4 sheet plates.
2026-03-13 feat: add latest combined sheet plate
    Combined v2/v4 sheet for single-plate printing.
2026-03-14 chore: update latest combined sheet plate
